dbt-grupp-5/rapport/figures/platformWithNotes.generated.pdf

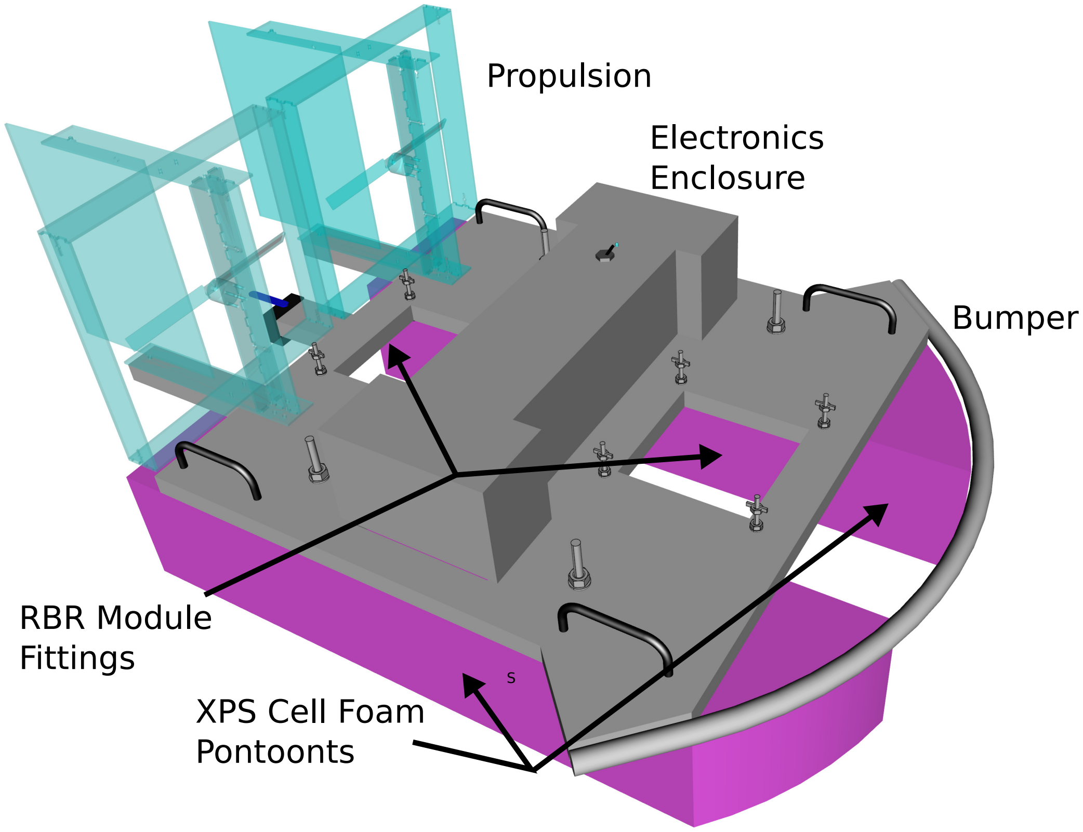
[picture p3: page 1]

Bumper

Electronics
Enclosure

Propulsion

RBR Module
Fittings
XPS Cell Foam
Pontoonts

S
