dbt-grupp-5/rapport/figures/platformWithNotes.pdf

Bumper

Electronics
Enclosure

Propulsion

RBR Module
Fittings
XPS Cell Foam
Pontoonts

S
