dbt-grupp-5/rapport/figures/propellerWithNotes.pdf

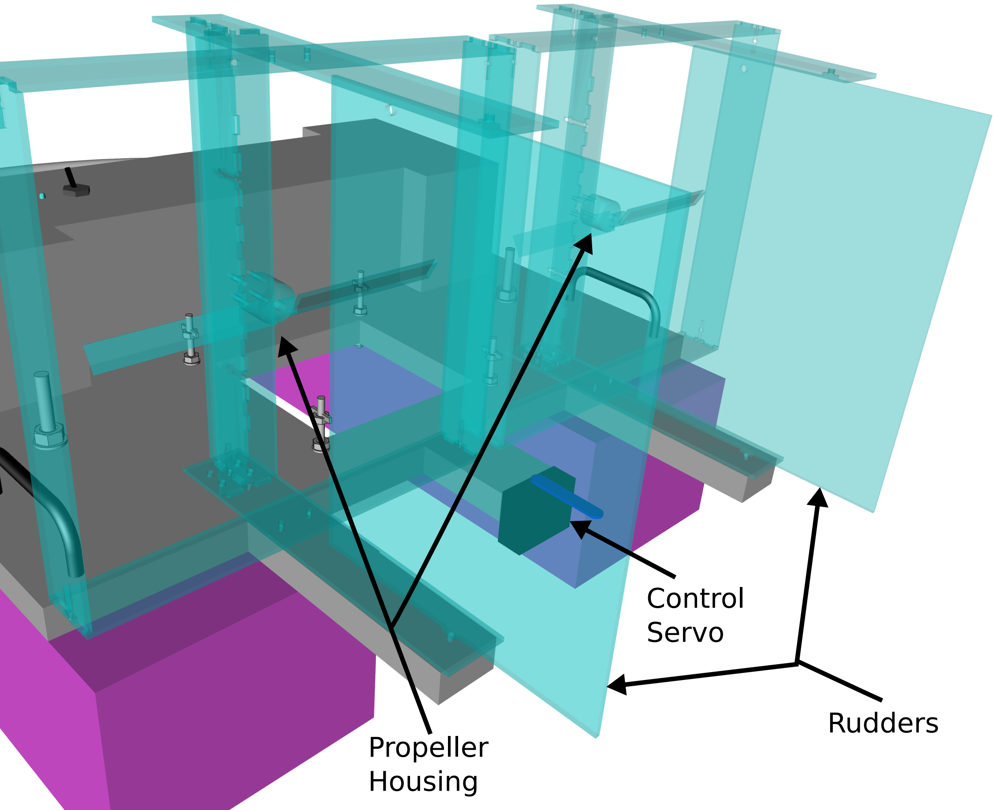
[picture p4: page 1]

Rudders

Control
Servo

Propeller
Housing
