dbt-grupp-5/rapport/figures/RBR-moduleWithNotes.pdf

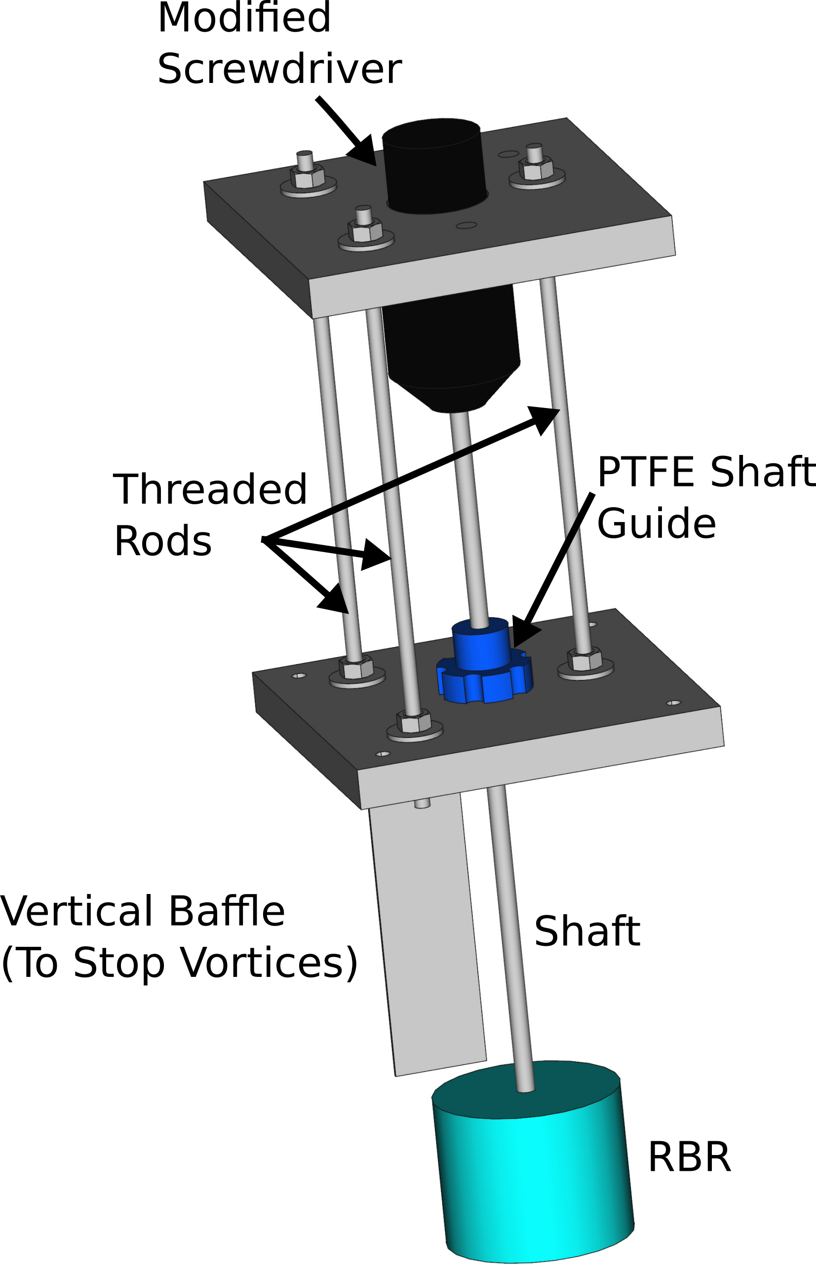
[picture p5: page 1]

PTFE Shaft
Guide

Vertical Ba e
(To Stop Vortices)

Modi ed
Screwdriver

Threaded
Rods

RBR

Shaft
