dbt-grupp-5/rapport/figures/Electric_cover.pdf

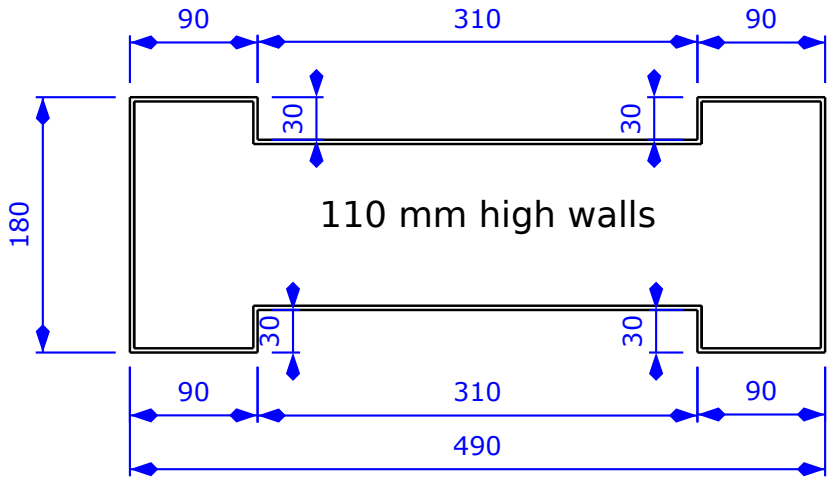
[picture p6: figure]
110 mm high walls
