dbt-grupp-5/rapport/figures/RBR_cover.pdf

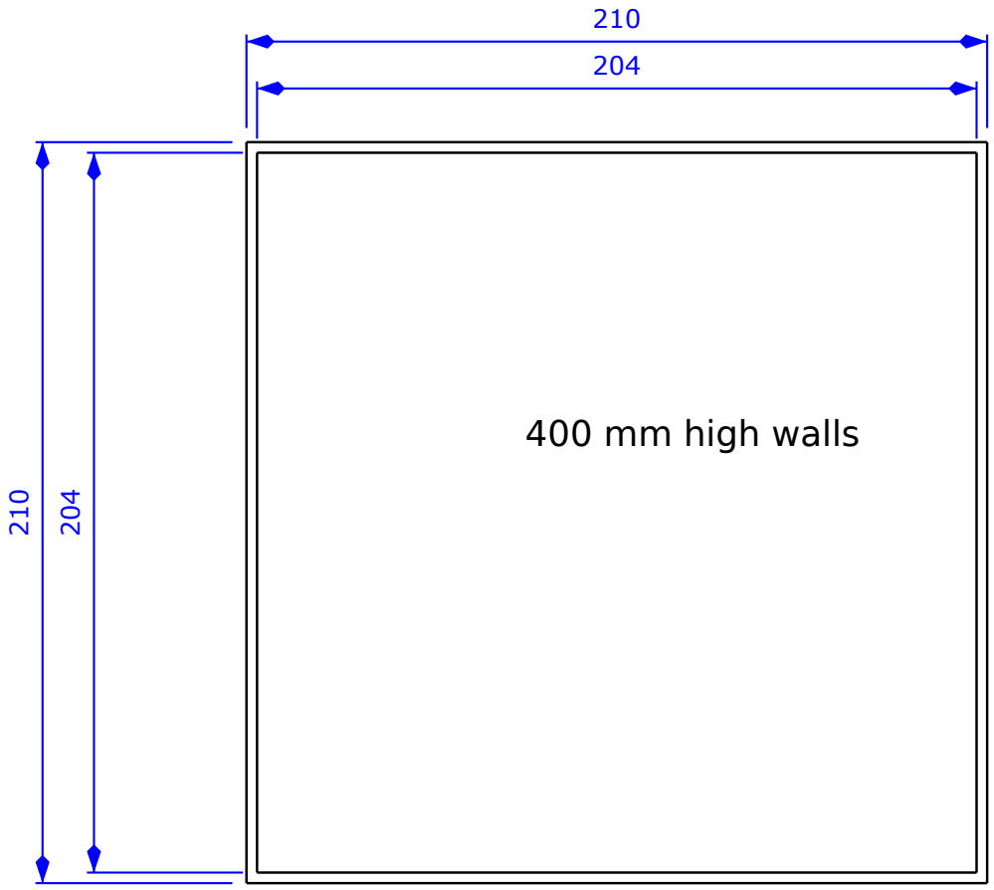
[picture p7: figure]
400 mm high walls
