dbt-grupp-5/rapport/figures/circuit.pdf

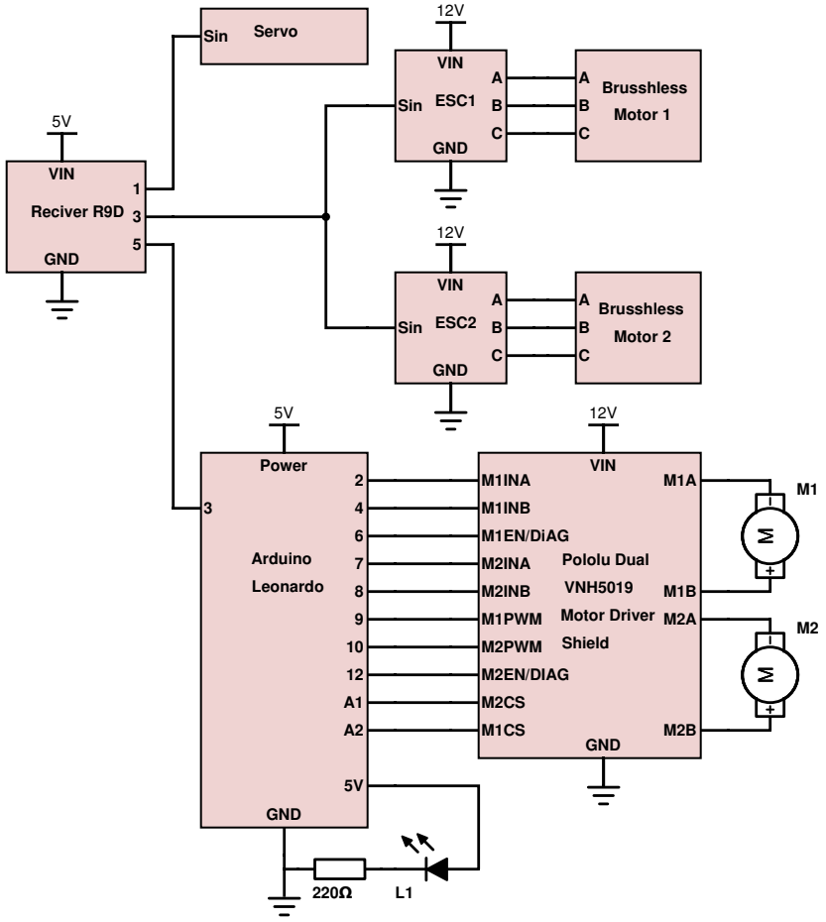
[picture p8: figure]
VIN; GND; Reciver R9D; Sin; Servo; ESC2; Sin ESC1; Brusshless; Motor 1; Motor 2; Arduino Leonardo; Power; M1EN/DiAG; M1INA M1INB; M2INA M2INB; M2PWM M2EN/DIAG M2CS M1CS; M1PWM; Motor Driver; Pololu Dual; Shield; VNH5019
