dbt-grupp-5/rapport/document.tex

\documentclass[11pt]{article}
\usepackage[english]{report}
\usepackage{titling}
\usepackage[titletoc,title]{appendix}
\setlength{\droptitle}{-3em}

\title{Floating Vehicle for Environmental \\ Cleaning of Large Liquid Masses}
\author{Anton Eriksson (aner0164@student.umu.se) \\
  Emelie Nordlinder (emno0046@student.umu.se) \\
  Jenny Bergman (jebe0070@student.umu.se) \\
  Jesper Vesterberg (jesper.vesterberg@umu.se) \\
  Joel Vedin (jove0027@student.umu.se) \\
  Johan Olovsson (joed0049@student.umu.se) \\
Rasmus Nyman (rany0004@student.umu.se)}

\date{\today}

\begin{document}
\begin{titlepage}
  \maketitle
  \thispagestyle{fancy}
  \lhead{
    Department of Physics\\
    Umeå University
  }
  \rhead{\today}

\begin{figure}[H]
   \centering
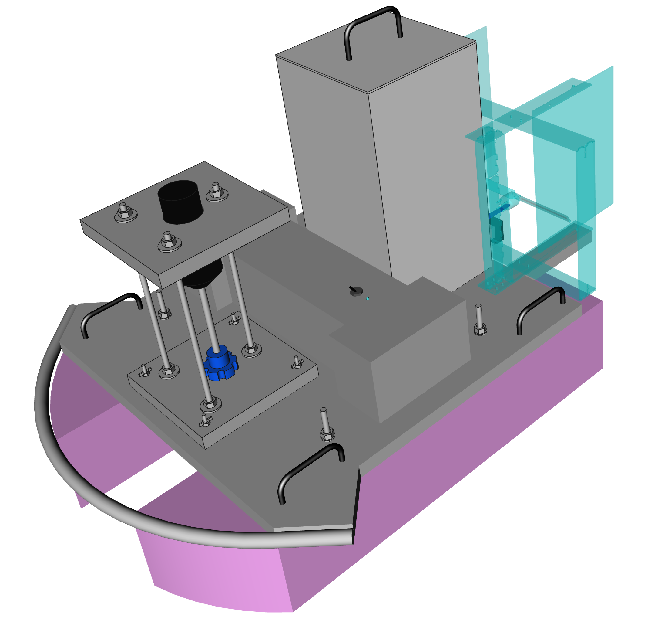
[picture p9: figures/front_box_off_2.png]
   
   %\label{fig:controller_front}
\end{figure}

  \begin{abstract}
    \noindent
    SpinChem\textsuperscript{\textregistered} has developed a rotating bed reactor (RBR) which can be used to
    clean fluids from particles or chemicals. This report describes the creation of a floating
    vehicle for mobilizing the RBR, which allows for cleaning large bodies of
    water via remote control. The vehicle use battery power to rotate the RBRs and propel it forward. It can be operated at large distances from the
    user. Emphasis has been placed on ease of transportation and cost
    effectiveness of the construction. Another part has been to test the adsorbtion ability of five different materials to be used in RBRs. Of the five materials goethite showed the most promising results. Large scale tests showed that a simulated water
    contaminant can be effectively cleaned with the vehicle. Future development
    could include autonomous deployment, and adapting the vehicle to more specialized purposes. There is also a possibility
    to produce a lighter version of the vehicle, using more advanced
    production methods.
  \end{abstract}

  \cfoot{
    Design-Build-Test, 15 ECTS\\
    Supervisor: Krister Wiklund
  }
\end{titlepage}

\lhead{\thetitle}
\rhead{\today}
\cfoot{\thepage}

\input{projektgruppen.tex}
\clearpage
\tableofcontents
\clearpage

\input{introduction.tex}
\clearpage
\part{Instructions and Descriptions of floating veichle}
\input{floatingPlatform.tex}

\clearpage
\input{radioController.tex}
\clearpage
\input{electronics.tex}
\clearpage

\part{Analyze of Floating Veichle Construction}
\input{thoughtsAndImprovements.tex}
\clearpage

\part{Testing of Cleaning Properties}
\input{materialTest.tex}
\clearpage
\input{largeScaleTest.tex}
\clearpage
\part{Compliance to Specification and Acknowledgements}
\input{complienceToSpec.tex}
\clearpage
\input{acknowledgments.tex}
\clearpage
\begin{thebibliography}{9}
    \bibitem{ford}
        Ford, M. A,
        \emph{Atomic absorption spectroscopy}.
        Nature. 1979, Vol.278, p.584

    \bibitem{boss}
        Charles B. Boss and Kenneth J. Fredeen,
        \emph{Concepts, Instrumentation and Techniques in Inductively Coupled Plasma Optical Emission Spectrometry},
        2004

    \bibitem{fassel}
        Velmer A. Fassel, Richard N. Kniseley,
        \emph{Inductively coupled plasma. Optical emission spectroscopy},
        Anal. Chem. 1974. Vol 46 (13), pp. 1110A-1120A

    \bibitem{url}
        \emph{Safety data sheet},
\url{http://www.sigmaaldrich.com/MSDS/MSDS/DisplayMSDSPage.do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},
    SIGMA-ALDRICH, 2016, aquired 08-01-2016

    \bibitem{pierre}
        Pierre Bouguer,
        \emph{Essai d'optique sur la gradation de la lumière},
        Paris, France: Claude Jombert, 1729 pp. 16–22.

\end{thebibliography}
\clearpage

\appendix
\begin{appendices}
  \input{appendix.tex}
\end{appendices}
\end{document}
