dbt-grupp-5/rapport/figures/bottom_plank.pdf

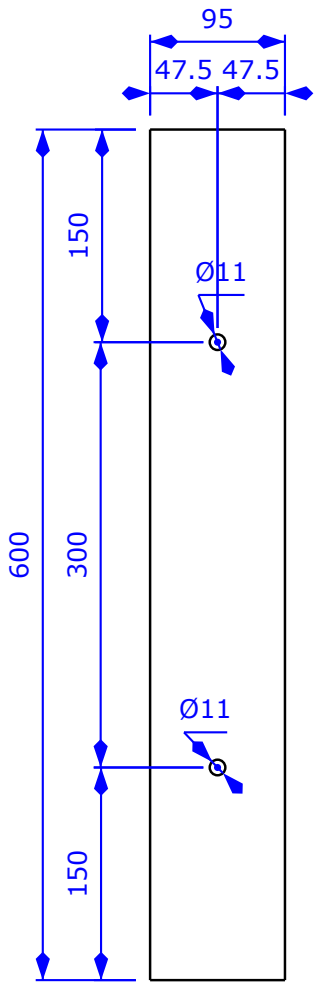
[picture p10: figure]
