dbt-grupp-5/rapport/figures/Powersupply.pdf

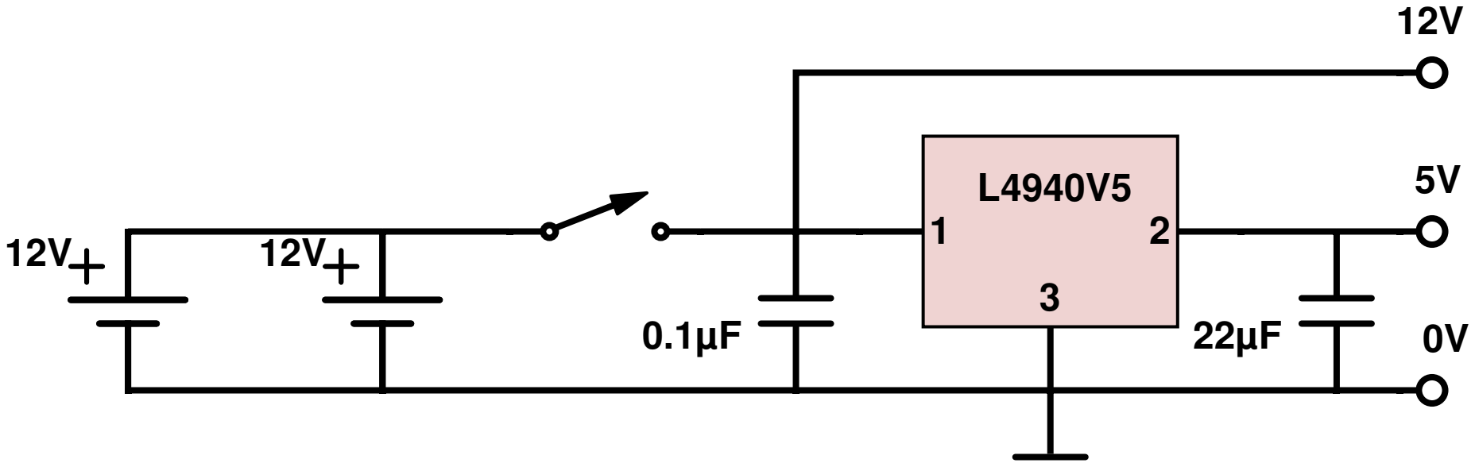
[picture p11: figure]
