dbt-grupp-5/rapport/figures/2015-12-18 12.48.49.jpg

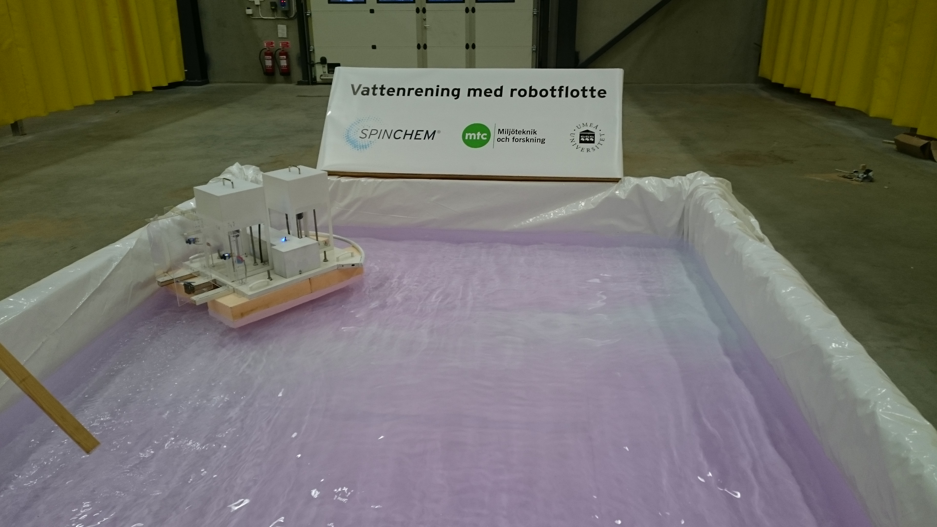
figures/2015-12-18 12.48.49.jpg
