dbt-grupp-5/rapport/figures/back.png

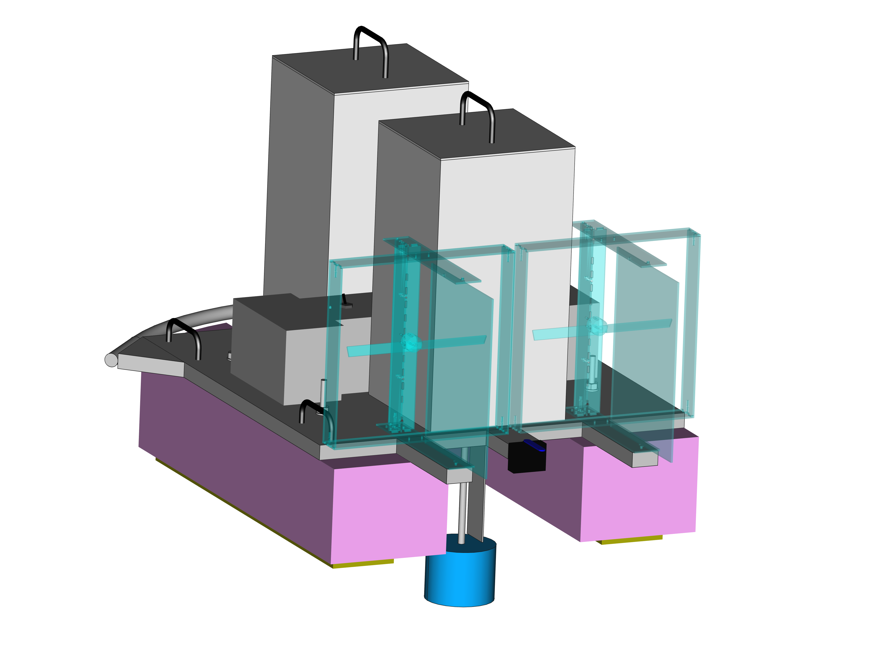
figures/back.png
