dbt-grupp-5/rapport/figures/flotte.PNG

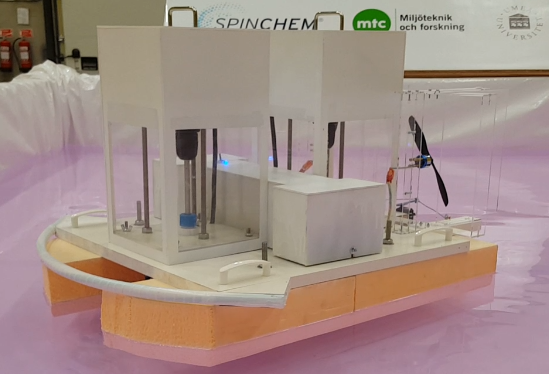
figures/flotte.PNG
