dbt-grupp-5/rapport/figures/front2.png

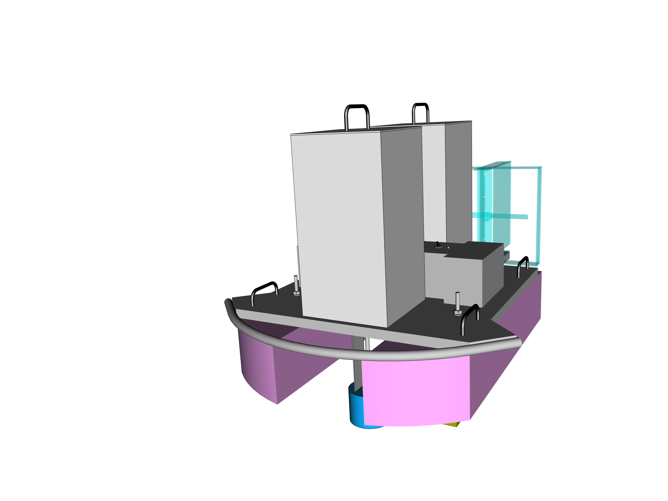
figures/front2.png
