dbt-grupp-5/rapport/figures/front3.png

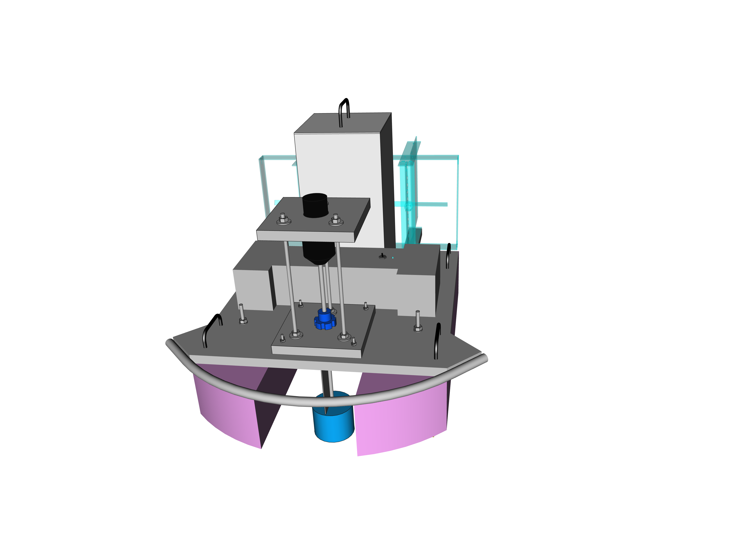
figures/front3.png
