dbt-grupp-5/rapport/figures/front4.png

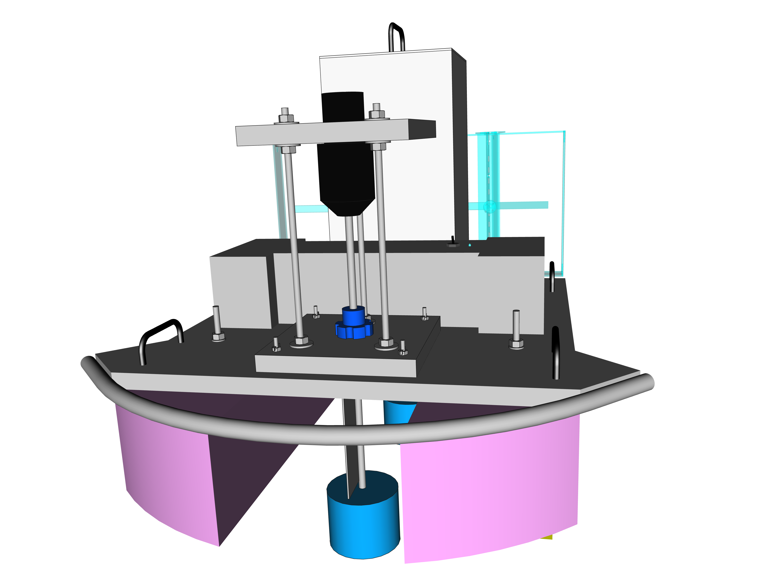
figures/front4.png
