dbt-grupp-5/rapport/figures/front.png

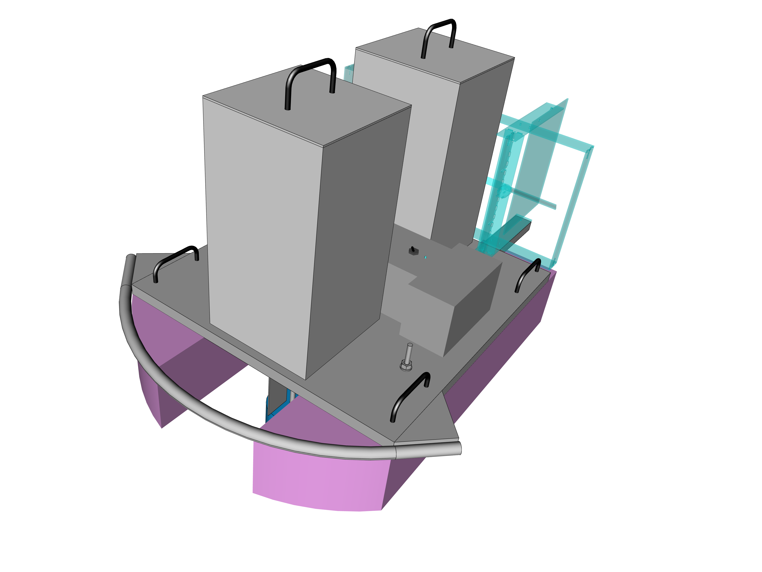
figures/front.png
