dbt-grupp-5/rapport/figures/front_box_off.png

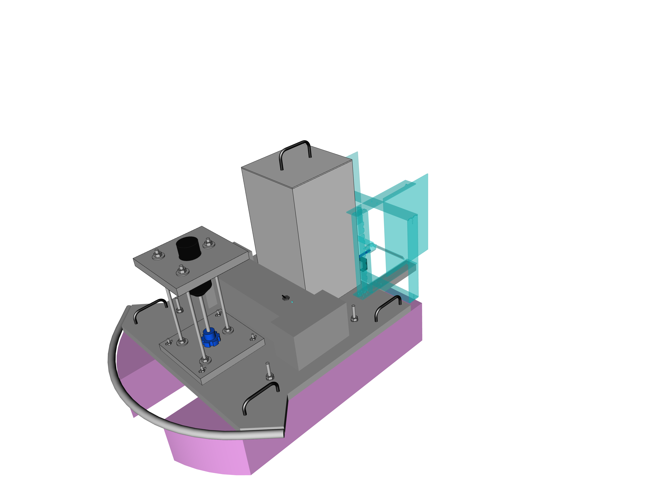
figures/front_box_off.png
