dbt-grupp-5/rapport/figures/platform.png

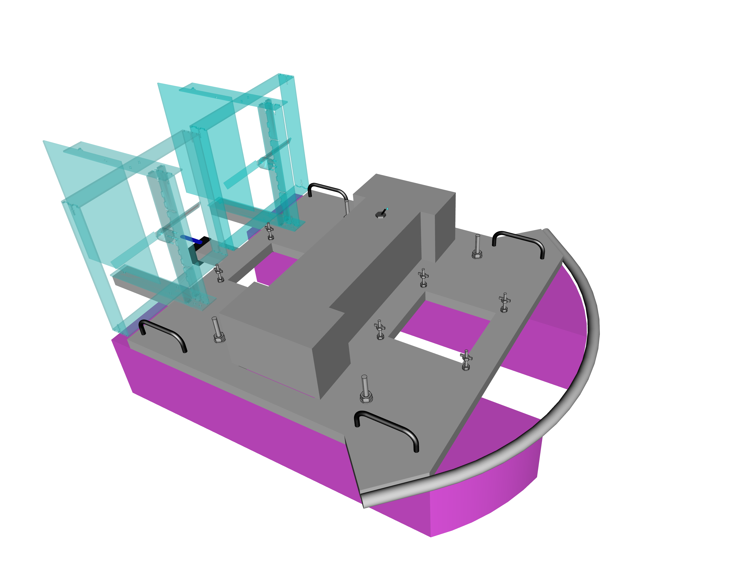
figures/platform.png
