dbt-grupp-5/rapport/figures/propeller.png

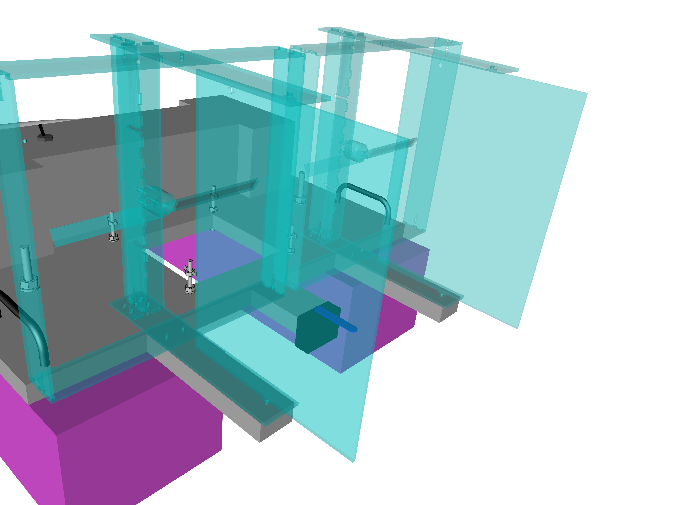
figures/propeller.png
