dbt-grupp-5/rapport/figures/RBR-module.png

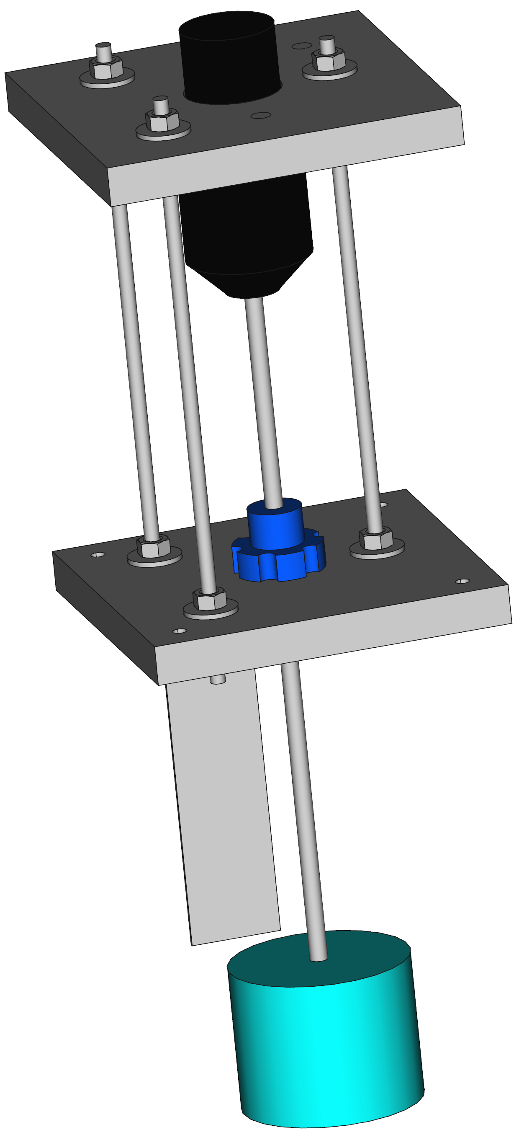
figures/RBR-module.png
