dbt-grupp-5/rapport/figures/received_10153139263531566.jpeg

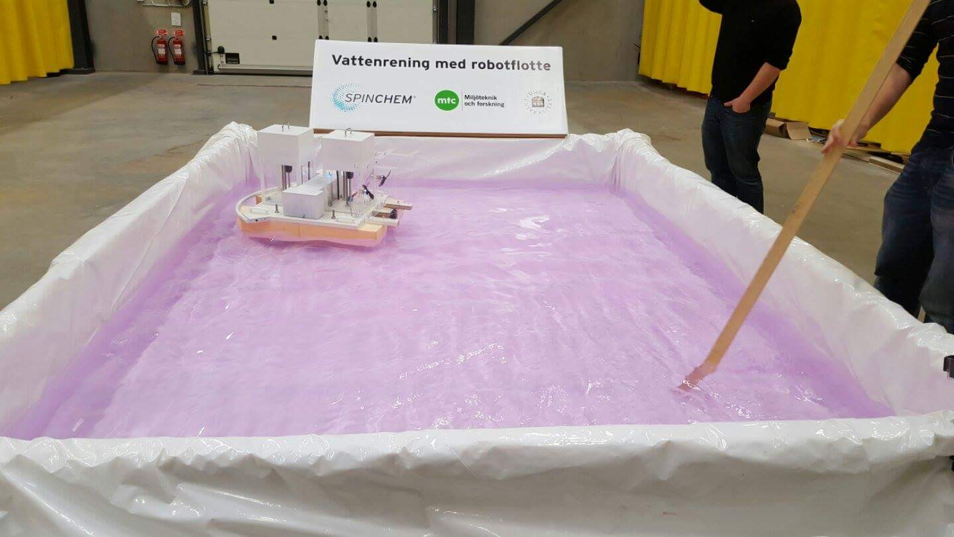
figures/received_10153139263531566.jpeg
