dbt-grupp-5/rapport/figures/Vk1.jpg

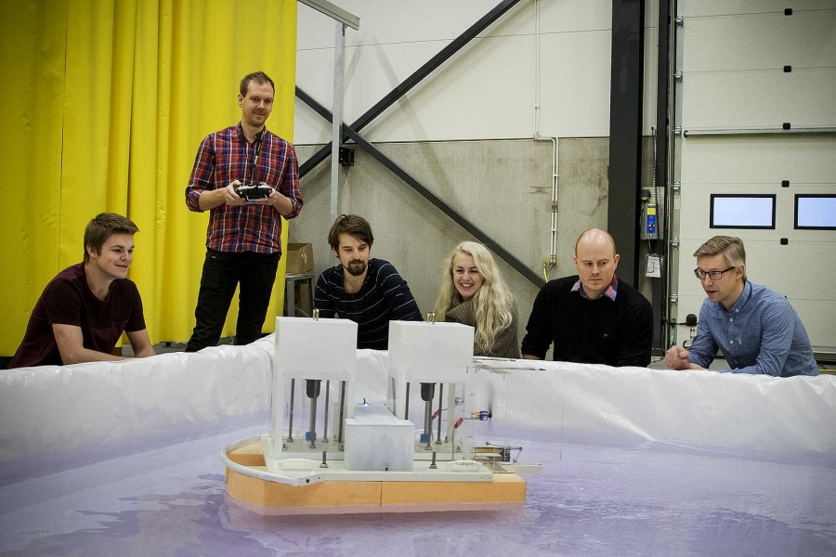
figures/Vk1.jpg
