dbt-grupp-5/rapport/figures/VK2.jpg

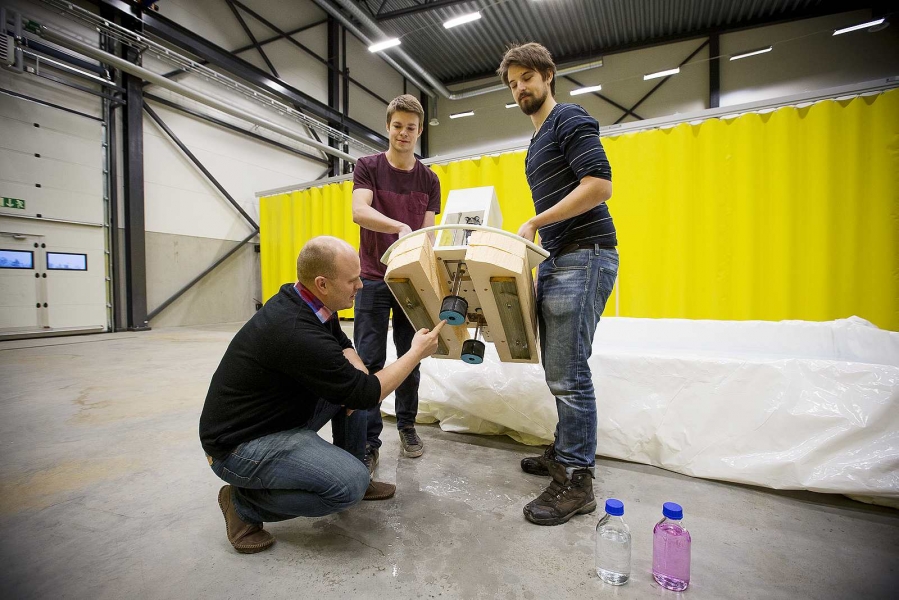
figures/VK2.jpg
