dbt-grupp-5/rapport/figures/VK3.jpg

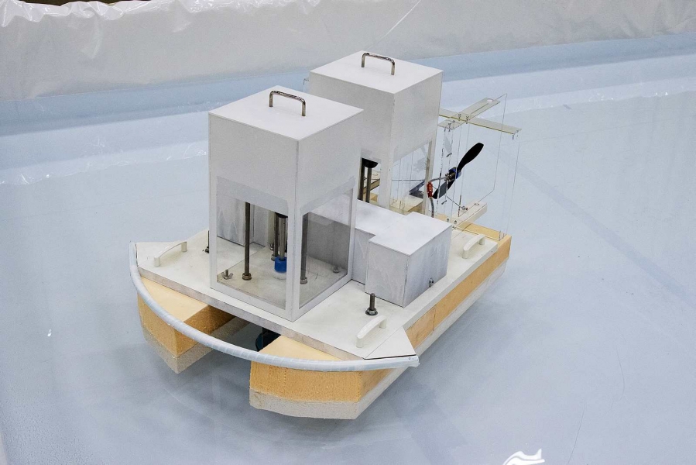
figures/VK3.jpg
