dbt-grupp-5/rapport/figures/mainPlate.pdf

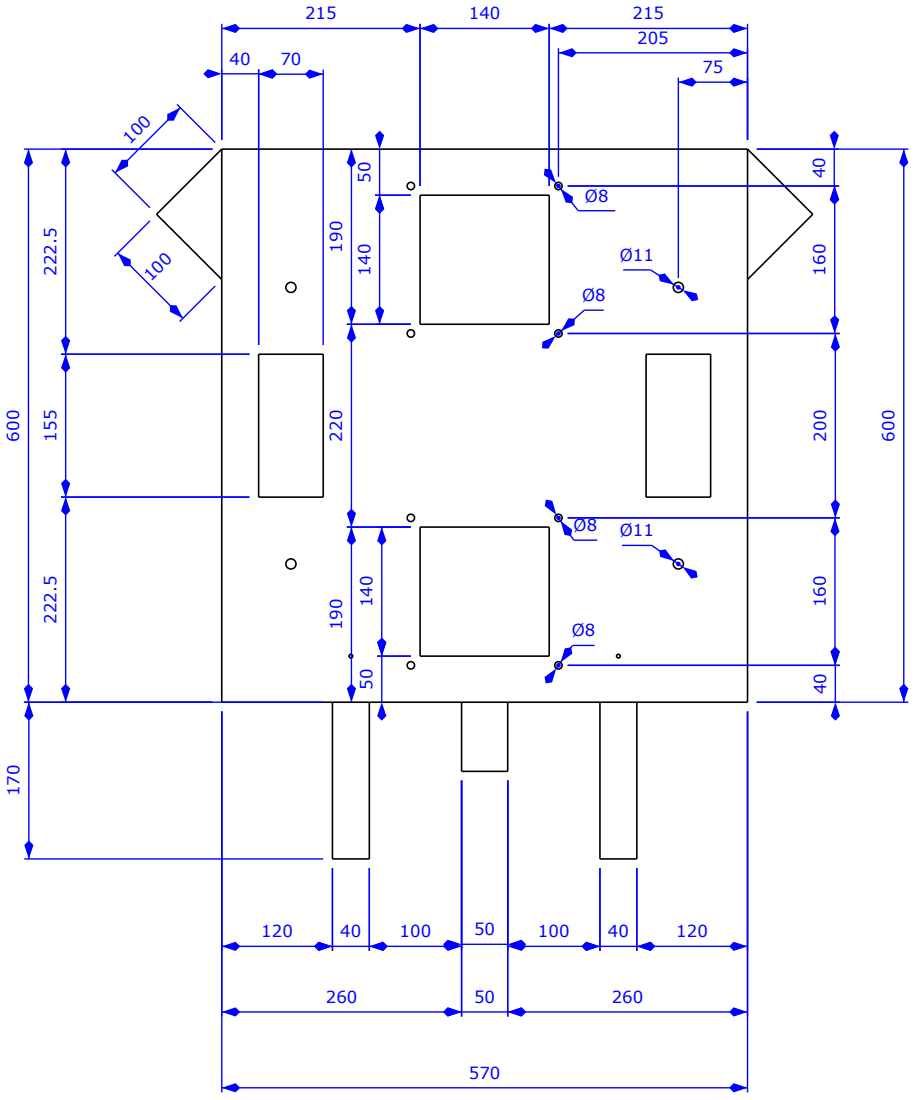
[picture p33: page 1]
