dbt-grupp-5/rapport/figures/ponton.pdf

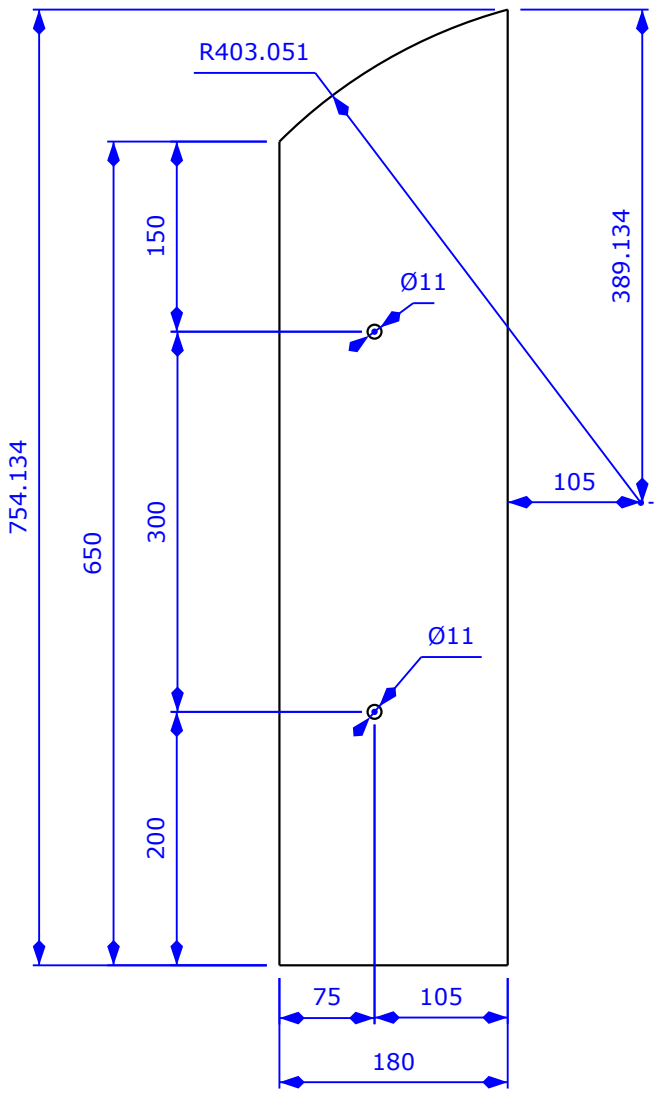
[picture p34: page 1]
