dbt-grupp-5/rapport/figures/RBR_mod_Bottom.pdf

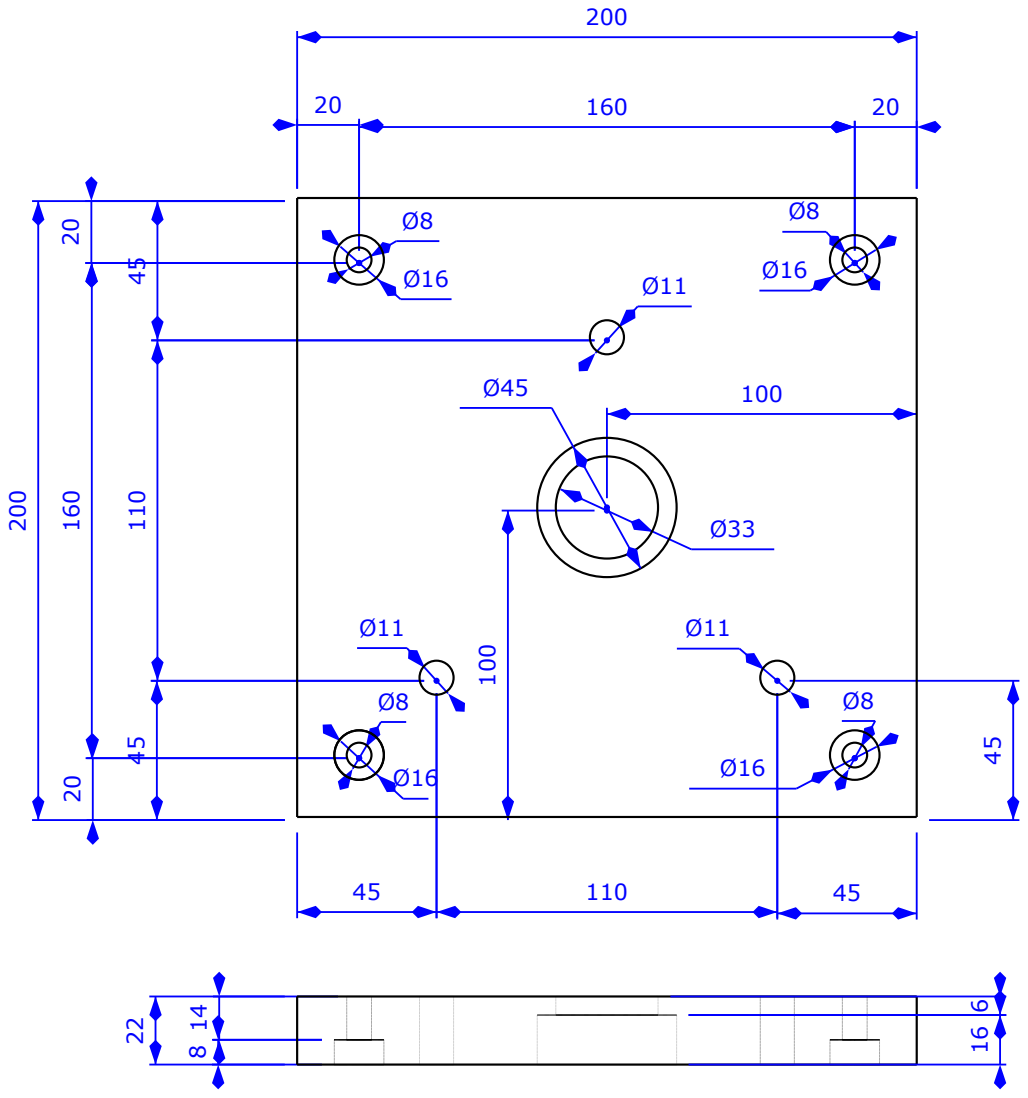
[picture p35: page 1]
