dbt-grupp-5/rapport/figures/RBR_mod_Top.pdf

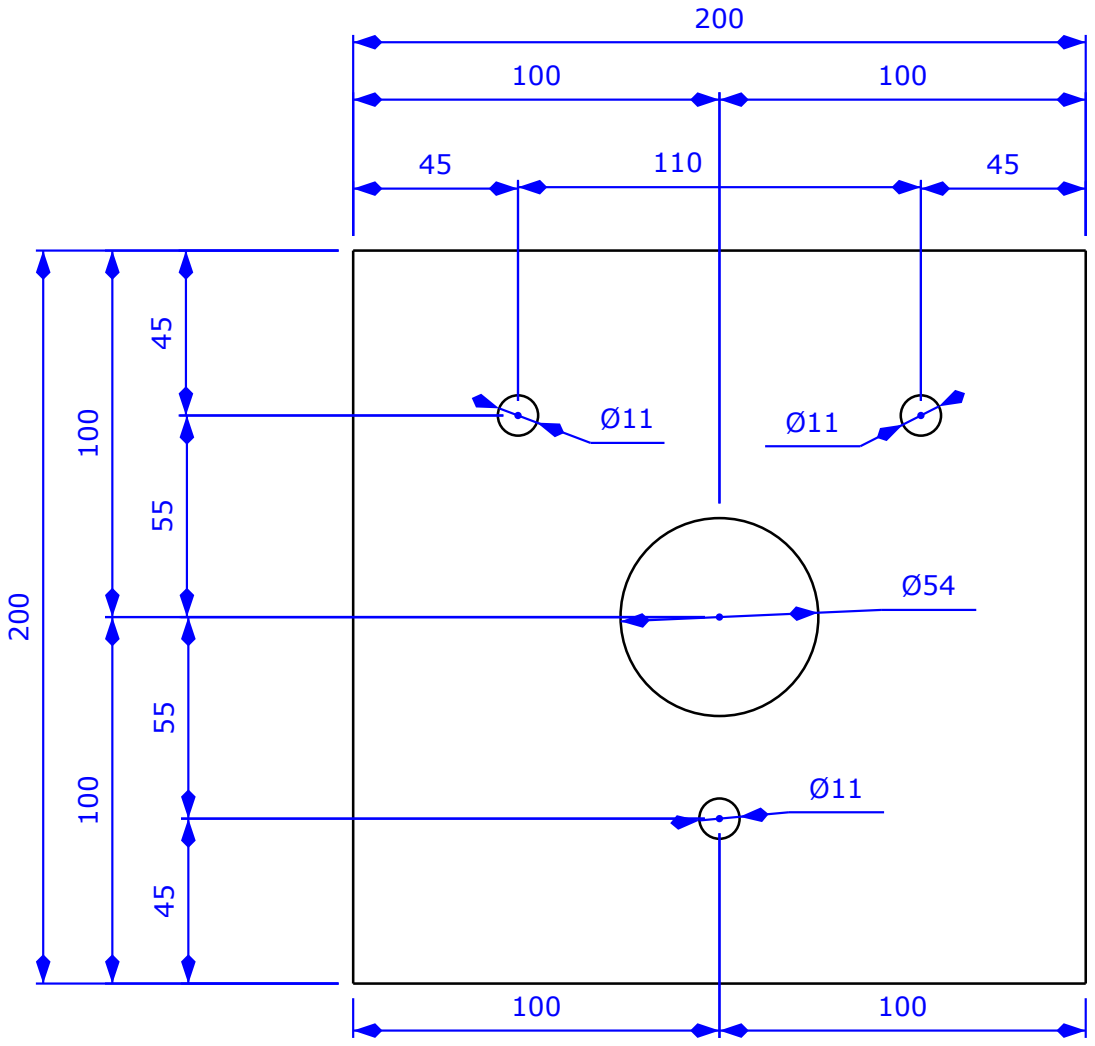
[picture p36: page 1]
