dbt-grupp-5/rapport/(commit log)

2016-01-06 Dont track pdf file
2016-01-07 dont track .genrated.pdf
2016-01-08 Split appendix into more sections. (Materials and blueprints)
2016-01-11 Added source code for the Arduino
2016-01-11 Small changes to appendix file, and baffle --> plate in the description of the RBR module
